Tokoro0917/RoboSweep_Mice2026/docs/rules/robosweep-rules.md

# ロボスイープ競技 ルールまとめ

調査日: 2026-11-12

> **注意: 公式の競技規程ページ（<https://ntf.or.jp/robosweep/rule/>）は、調査時点で非公開（404）でした。**
> このページは、確認できた資料と検索エンジンに残っていた抜粋から作ったものです。
> 規程が再公開されたら、必ず原文で確認して更新してください。

情報の確かさで 3 つに分けて書いています。

- **A. 一次資料で確認したこと**: 主催者が出した資料を直接読んで確認した
- **B. 規程の抜粋（未確認）**: 検索結果に残っていた規程の一部。原文は未確認
- **C. 解釈・推測**: A と B からの推測

---

## A. 一次資料で確認したこと

### 競技の概要
2026年度関西地区大会の告知（[マイクロマウス委員会 関西支部](https://mmk.rulez.jp/?p=3079)）より:

- 「複数台のロボットが協力してフィールド内のボールを減らし、得点を競う**対戦型**の競技」
- 2026年度から新しく始まった種目
- 参加費は**無料**（他の競技は 1 台 2000 円）
- エントリーは Google フォームから受け付けていた（関西大会の締切は 7/10）

### フィールド（関西大会で使われた迷路）
[公開されていた迷路の画像](https://ntf.or.jp/robosweep/wp-content/uploads/2026/07/FY26関西地区大会迷路.jpg)より:

- **16×16 区画の迷路**で、マイクロマウスの迷路と同じ形式
- 中央の太線で**左右に分かれていて、それぞれが各チームの陣地**
- ボール（黄色）は**各陣地に 2 個ずつ、計 4 個**置かれていた

### 大会の形式（関西大会）
[対戦表](https://ntf.or.jp/robosweep/wp-content/uploads/2026/07/FY26関西地区大会結果.png)より:

- 6 チームによるトーナメント。1 試合はおよそ 7〜15 分間隔で進行していた
- スコアは「0-5」「2-0」「0-3」「0-0」など
  - B にある「計測は 5 回で、1 回につき 1 点」という抜粋と矛盾しない
- 表彰は優勝・準優勝・特別賞

### 参加チームの構成例
優勝チームのエントリーシート（[2026kansai_entry_1.pdf](https://ntf.or.jp/robosweep/wp-content/uploads/2026/07/2026kansai_entry_1.pdf)）より:

- 同じ機体 2 台で 1 チーム。迷路を半分ずつ担当していた
- 2 台は Wi-Fi ルーターにつないだ同じ LAN 内で通信していた（ロボット同士の通信は使えるとみられる）
- ボールを吸引でつかみ、バネで打ち出す方式
- カメラで黄色い部分を見つけてボールを検出していた
- 主な部品: Raspberry Pi 5、ESP32-S3、ATmega328、IR 壁センサ、IMU、エンコーダ

### 公式の参考機体「ムブアイ」
三菱電機が、競技の参考になる機体の資料を公開しています（[ntf.or.jp/robosweep の uploads](https://ntf.or.jp/robosweep/wp-content/uploads/2026/06/)）。

- `機体HW.zip`: 回路図、CAD（STEP）、ハードウェア説明
- `ファームウェア.zip`: RX66N と FreeRTOS で動くファームウェア、説明資料
- `調整ソフト.zip`: Windows で動く調整用の GUI
- `ライセンス規約.pdf`

機体の主な仕様（ハードウェア説明より）:

- 重さ: 約 450 g
- 走行性能の目標: 最高速度 2 m/s
- バッテリー: Li-Po 2S 900mAh。連続 20 分動かすことを想定
- 処理系: Raspberry Pi 4B（通信・アルゴリズム）と RX66N（制御）
- ボールの扱い: 2 軸アームと遠心ファンで吸着する

> ⚠️ **ムブアイの資料はこのリポジトリに置かないでください。**
> ライセンス規約は「社外秘」扱いで、配布できるのは「本競技を目的とする開発グループ内」までです。
> **不特定の第三者への配布は禁止**されています。商用利用も禁止です。
> このリポジトリは Public なので、zip・PDF・CAD・ソースコード（改変したものも含む）をコミットすると規約違反になります。
> 各自が上の URL からダウンロードしてください。

---

## A2. チームで確認した規程の内容

チームの引き継ぎメモ（NTF 競技規程を読んだもの）より。

| 項目 | 内容 |
| --- | --- |
| フィールド | 18cm 区画が **16 × 16**。壁の高さ **5cm**、厚さ **1.2cm**（通路の内幅 16.8cm） |
| 陣地 | 両陣地は壁で分けられている。**本体の一部でも相手陣地に入ってはいけない** |
| ボール | ポリウレタン製、Φ70mm、19g。各陣地の指定位置に 2 個ずつ。**置く位置は事前に公表される** |
| 試合時間 | **5 分** |
| 得点 | 試合中の好きなタイミングで **5 回** ボールの数を数え、自陣のボールが少ないチームに 1 点 |

> ✅ **壁越しにボールを投げてよいことを、大会に確認しました**（2026-11-12、チームより）。
> アームを壁の上に出して、自動で相手陣地へ投げる方法で進めます（Issue #11）。
> 本体（車体）の一部を相手陣地に入れてはいけない、というルールは変わりません。

---

## B. 規程の抜粋（未確認）

検索エンジンに残っていた規程の一部です。**原文は確認できていません。**条番号は抜粋に書かれていたものです。

| 項目 | 内容 |
| --- | --- |
| 定義 | ロボットが自陣地の未知のフィールドにある複数のボールを自分で見つけ、相手陣地に送り込む。競技中に何回か各陣地のボール数を数え、その数をもとにポイントを競う |
| 1-1 | エージェント（ロボット）は自立型でなければならない。燃焼を使うエネルギー源は禁止 |
| 1-2 | 競技中に操作者がハードウェアやソフトウェアを変更してはいけない |
| — | ロボットの本体の一部でも相手陣地に入ってはいけない |
| — | 出場するロボットの**合計重量は 2.0 kg 以内**。台数の制限はない |
| — | ボールはポリウレタン製で、**直径 70 mm、重さ 19 g** |
| 3-1 | 競技開始時、両陣地の指定の位置にボールを 2 個ずつ置く |
| 4-2 | 競技開始前に決めたタイミングで**計 5 回**、各陣地のボール数を数える。そのとき**自陣のボールが少ないチームに 1 点** |
| 4-3 | フィールドの形は競技開始まで公開されない。事前に情報を手に入れてはいけない |

---

## C. 解釈・推測

- 迷路は事前に分からないので、**探索しながらボールを見つける**必要がある
- 自陣のボールを減らすことが得点につながる。車体は相手陣地に入れないので、アームで**壁越しに投げる**（大会に確認済み）
- 合計 2.0 kg 以内なら台数は自由なので、**台数と 1 台あたりの重さのバランス**が設計のポイントになる
- 5 回の計測で点が決まるので、序盤から早くボールを送ることが大事そう

## 不明なこと（規程の再公開待ち）

- 壁の色、床の色と材質
- 機体の大きさの制限
- 無線通信の規定（周波数、外部 PC を使ってよいか）
- 同点のときの決め方、反則とペナルティ
- スタート位置とスタートの手順

## 出典

- 関西地区大会の告知: <https://mmk.rulez.jp/?p=3079>
- 競技規程（調査時点で 404）: <https://ntf.or.jp/robosweep/rule/>
- 迷路・結果・エントリーシート・ムブアイ資料: <https://ntf.or.jp/robosweep/wp-content/uploads/>
