Tokoro0917/RoboSweep_Mice2026/hardware/electrical/remote-controller/production/bom.csv

Designator | Footprint | Quantity | Value | LCSC Part #
C1 | 0603 | 1 | 0.1u
C2 | 0603 | 1 | C_Small
D1, D2 | LED_D3.0mm | 2 | LED
DS1 | AQM0802A | 1 | AQM0802A
R1, R10, R11, R2, R3, R4, R5, R6, R7, R8 | 0603 | 10 | R
R9 | 0603 | 1 | 10k
SW1, SW2, SW3, SW4, SW5, SW6, SW7, SW8 | SW_PUSH_6mm | 8 | SW_Push
U1 | xiao_esp32c3 | 1 | XIAO ESP32C3
