Tokoro0917/RoboSweep_Mice2026/hardware/electrical/DOM-SWEEP/production/bom.csv

Designator | Footprint | Quantity | Value | LCSC Part #
C1, C10, C12, C5, C7, C9 | C_Radial_D5.0mm_H11.0mm_P2.00mm | 6 | 100u
C11, C13, C14, C16, C17, C19, C2, C20, C3, C4, C6 | 0603 | 11 | 0.1u
C15 | 0603 | 1 | 4.7u
C18 | 0805 | 1 | 22u
C8 | 0603 | 1 | 1u
D1 | 1N4007-3485 | 1 | 1N4007-3485
D6, D7, D8, D9, POWERLED1 | 0603 | 5 | LED
IC1 | QFP50P1200X1200X160-64N | 1 | STM32F446RET6
IC2 | NJM7805 | 1 | NJM7805
IC3, IC4 | SLA7073MPRT | 2 | SLA7073MPRT
IC5 | NJU7223F33 | 1 | NJU7223F33
J1 | MotorPinHeader | 1 | Motor_L
J2 | MotorPinHeader | 1 | Motor_R
J3 | PinHeader_2x03_P2.54mm_Vertical | 1 | Conn_02x03_Odd_Even
J4 | PinHeader_2x10_P2.54mm_Vertical | 1 | Conn_02x10_Odd_Even
JP1 | BatteryTerminal | 1 | ~
LED1, LED2, LED3, LED4 | OS5RKA5111P | 4 | OS5RKA5111P
Q1, Q3, Q7 | 2SC1815 | 3 | 2SC1815
Q2, Q6 | MTB060P06I3 | 2 | MTB060P06I3
Q4, Q5, Q8, Q9 | ST1KL3A | 4 | ST-1KL3A
R1, R12, R13, R16, R22, R3, R8 | 0603 | 7 | 10K
R10, R11, R14, R19, R2, R20, R23, R24, R25, R27, R7 | 0603 | 11 | 4.7K
R15 | Potentiometer_Bourns_3296W_Vertical | 1 | ~
R17, R9 | 0603 | 2 | 51
R4 | 0603 | 1 | 100K
R5 | 0603 | 1 | 22K
S3, S5, S6 | SMT(4.2X3.2) | 3 | SKRPACE010
S4 | SSSS213202 | 1 | SSSS213202
U2 | UGCM1205XP | 1 | UGCM1205XP
Y1 | CSTNE10M0G55A000R0 | 1 | CSTNE10M0G55A000R0
