Tokoro0917/RoboSweep_Mice2026/hardware/electrical/DOM-SWEEP/DOM-SWEEP.csv

Reference | Qty | Value | DNP | Exclude from BOM | Exclude from Board | Footprint | Datasheet
C1,C5,C7,C9,C10,C12 | 6 | 100u |  |  |  | Capacitor_THT:C_Radial_D5.0mm_H11.0mm_P2.00mm | ~
C2,C3,C4,C6,C11,C13,C14,C16,C17,C19,C20 | 11 | 0.1u |  |  |  | Capacitor_SMD:C_0603_1608Metric | ~
C8 | 1 | 1u |  |  |  | Capacitor_SMD:C_0603_1608Metric | ~
C15 | 1 | 4.7u |  |  |  | Capacitor_SMD:C_0603_1608Metric | ~
C18 | 1 | 22u |  |  |  | Capacitor_SMD:C_0805_2012Metric | ~
D1 | 1 | 1N4007-3485 |  |  |  | new_freshman_cm-footprint:1N4007-3485 | https://akizukidenshi.com/download/1n4007_panjit.pdf
D6,D7,D8,D9,PowerLED1 | 5 | LED |  |  |  | LED_SMD:LED_0603_1608Metric | ~
IC1 | 1 | STM32F446RET6 |  |  |  | STM32F446RET6:QFP50P1200X1200X160-64N | http://uk.rs-online.com/web/p/products/1106621P
IC2 | 1 | NJM7805 |  |  |  | new_freshman_cm-footprint:NJM7805 | https://datasheet.datasheetarchive.com/originals/distributors/Datasheets-DGA25/1772503.pdf
IC3,IC4 | 2 | SLA7073MPRT |  |  |  | new_freshman_cm-footprint:SLA7073MPRT | http://www.semicon.sanken-ele.co.jp/sk_content/sla7070mprt_ds_en.pdf
IC5 | 1 | NJU7223F33 |  |  |  | NJU7223F33 | https://www.nisshinbo-microdevices.co.jp/ja/pdf/datasheet/NJU7223_J.pdf
J1 | 1 | Motor_L |  |  |  | new_freshman_cm-footprint:MotorPinHeader | ~
J2 | 1 | Motor_R |  |  |  | new_freshman_cm-footprint:MotorPinHeader | ~
J3 | 1 | Conn_02x03_Odd_Even |  |  |  | Connector_PinHeader_2.54mm:PinHeader_2x03_P2.54mm_Vertical | ~
J4 | 1 | Conn_02x10_Odd_Even |  |  |  | Connector_PinHeader_2.54mm:PinHeader_2x10_P2.54mm_Vertical | ~
JP1 | 1 | ~ |  |  |  | new_freshman_cm-footprint:BatteryTerminal
LED1,LED2,LED3,LED4 | 4 | OS5RKA5111P |  |  |  | new_freshman_cm-footprint:OS5RKA5111P | http://akizukidenshi.com/download/ds/optosupply/OS5RKA5111P.pdf
Q1,Q3,Q7 | 3 | 2SC1815 |  |  |  | new_freshman_cm-footprint:2SC1815 | http://www.mouser.com/datasheet/2/68/2sc1815-1149989.pdf
Q2,Q6 | 2 | MTB060P06I3 |  |  |  | new_freshman_cm-footprint:MTB060P06I3 | https://datasheet.datasheetarchive.com/originals/distributors/Datasheets-SFU2/DSASFU100039949.pdf
Q4,Q5,Q8,Q9 | 4 | ST-1KL3A |  |  |  | new_freshman_cm-footprint:ST1KL3A | https://www.kodenshi.co.jp/files/product/ST-1KL3A.pdf
R1,R3,R8,R12,R13,R16,R22 | 7 | 10K |  |  |  | Resistor_SMD:R_0603_1608Metric | ~
R2,R7,R10,R11,R14,R19,R20,R23,R24,R25,R27 | 11 | 4.7K |  |  |  | Resistor_SMD:R_0603_1608Metric | ~
R4 | 1 | 100K |  |  |  | Resistor_SMD:R_0603_1608Metric | ~
R5 | 1 | 22K |  |  |  | Resistor_SMD:R_0603_1608Metric | ~
R9,R17 | 2 | 51 |  |  |  | Resistor_SMD:R_0603_1608Metric | ~
R15 | 1 | ~ |  |  |  | Potentiometer_THT:Potentiometer_Bourns_3296W_Vertical
S3,S5,S6 | 3 | SKRPACE010 |  |  |  | SKRPACE010:SMT(4.2X3.2) | http://www.alps.com/prod/info/E/HTML/Tact/SurfaceMount/SKRP/SKRPACE010.html
S4 | 1 | SSSS213202 |  |  |  | SSSS213202:SSSS213202 | http://uk.rs-online.com/web/p/products/1238917
U2 | 1 | UGCM1205XP |  |  |  | new_freshman_cm-footprint:UGCM1205XP | https://akizukidenshi.com/download/ds/universalelectronics/UGCM1205XP.pdf
Y1 | 1 | CSTNE10M0G55A000R0 |  |  |  | CSTNE10M0G55A000R0:CSTNE10M0G55A000R0 | https://www.murata.com/products/productdata/8801160101918/SPEC-CSTNE10M0G55A000R0.pdf
