Tokoro0917/RoboSweep_Mice2026/hardware/suction-effector/robosweep_bracket.stl

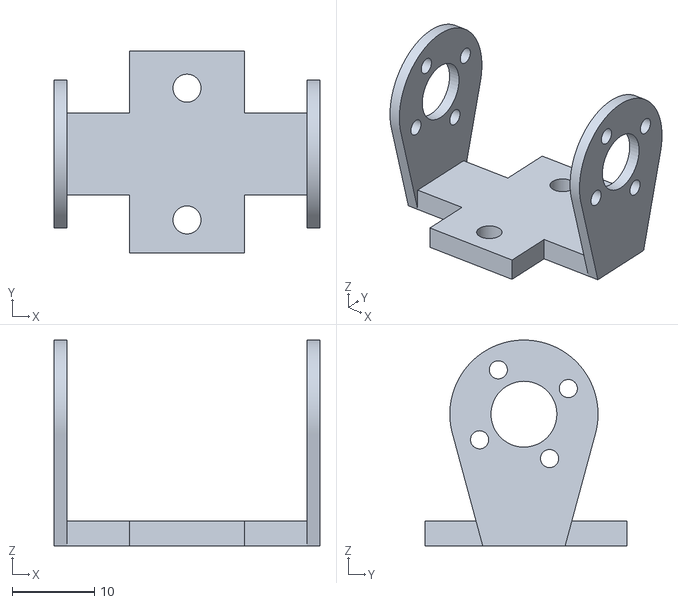
[picture p7: CAD file, 2026-11-13]
hardware/suction-effector/robosweep_bracket.stl
32.3 x 24.5 x 25.0
