Tokoro0917/RoboSweep_Mice2026/hardware/suction-effector/robosweep_bracket_pose.stl

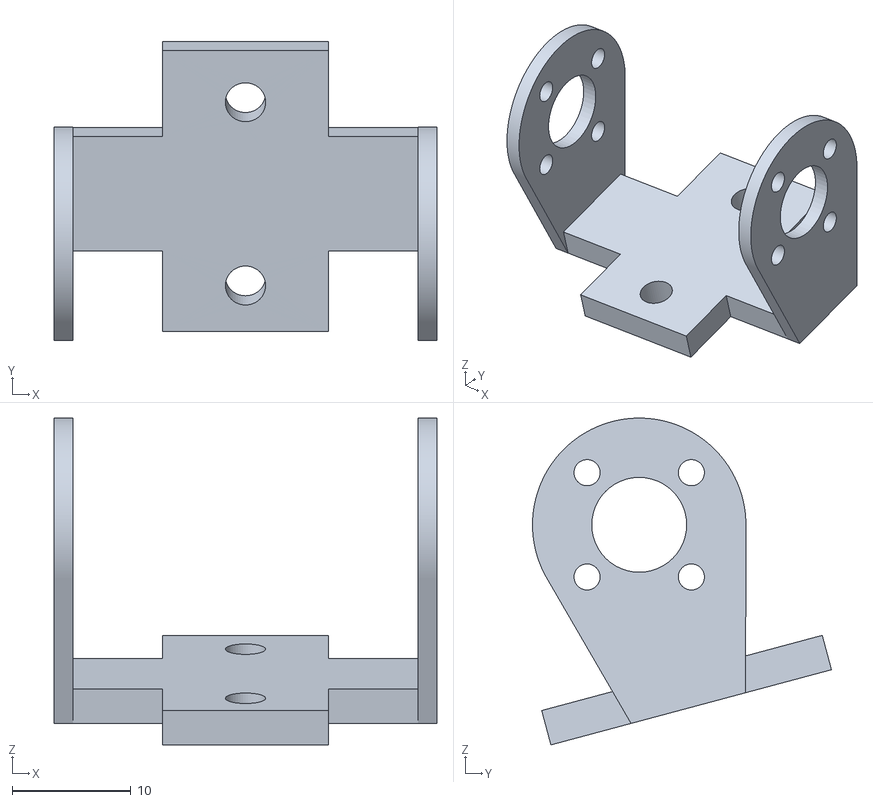
[picture p8: CAD file, 2026-11-13]
hardware/suction-effector/robosweep_bracket_pose.stl
32.3 x 25.2 x 27.6
