Tokoro0917/RoboSweep_Mice2026/hardware/suction-effector/robosweep_effector_upper_fit0.0.stl

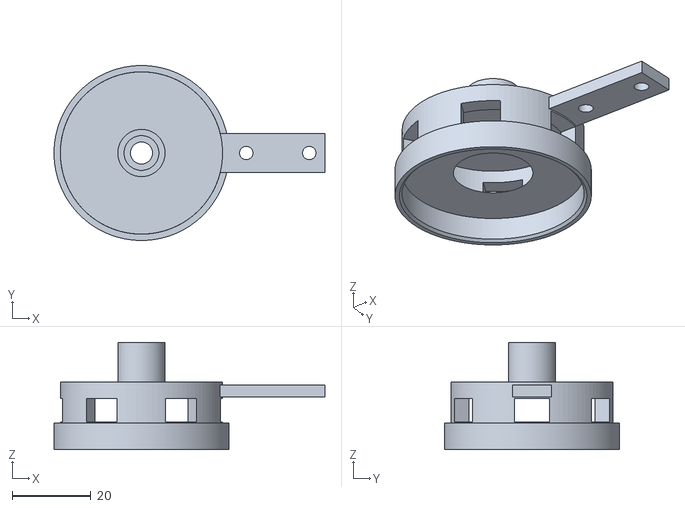
[picture p9: CAD file, 2026-11-12]
hardware/suction-effector/robosweep_effector_upper_fit0.0.stl
68.8 x 44.4 x 27.2
