Tokoro0917/RoboSweep_Mice2026/hardware/suction-effector/robosweep_impeller_d1.5.stl

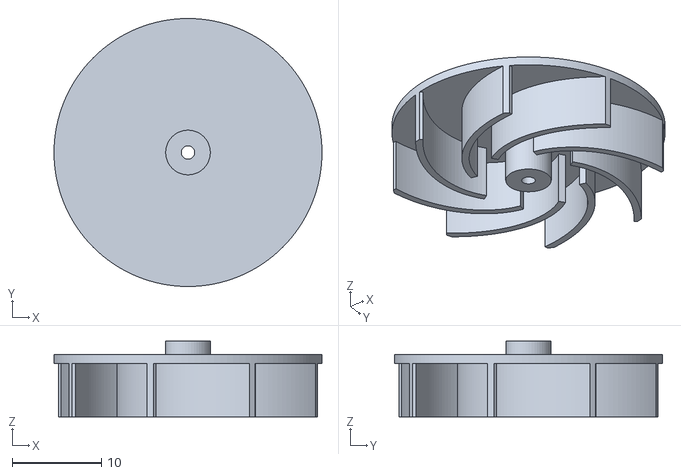
[picture p10: CAD file, 2026-11-12]
hardware/suction-effector/robosweep_impeller_d1.5.stl
30.0 x 30.0 x 8.50
