Tokoro0917/RoboSweep_Mice2026/hardware/suction-effector/robosweep_effector_lower.stl

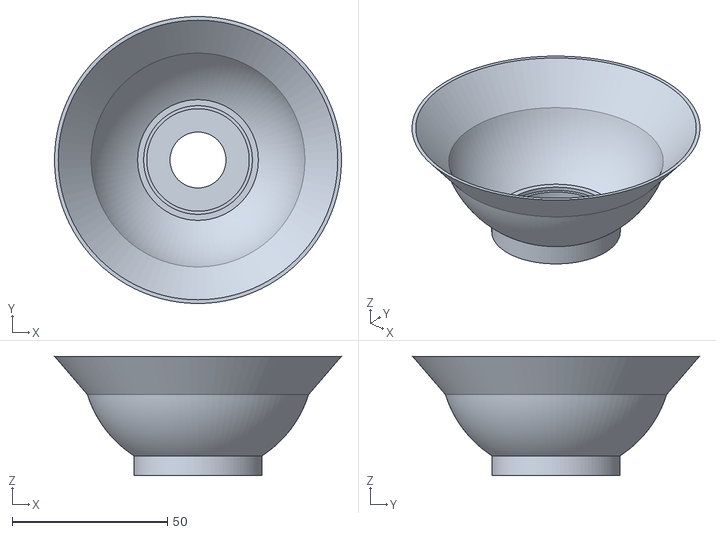
[picture p11: CAD file, 2026-11-12]
hardware/suction-effector/robosweep_effector_lower.stl
92.4 x 92.4 x 38.4
