Tokoro0917/RoboSweep_Mice2026/hardware/suction-effector/robosweep_effector_upper_fit-0.2.stl

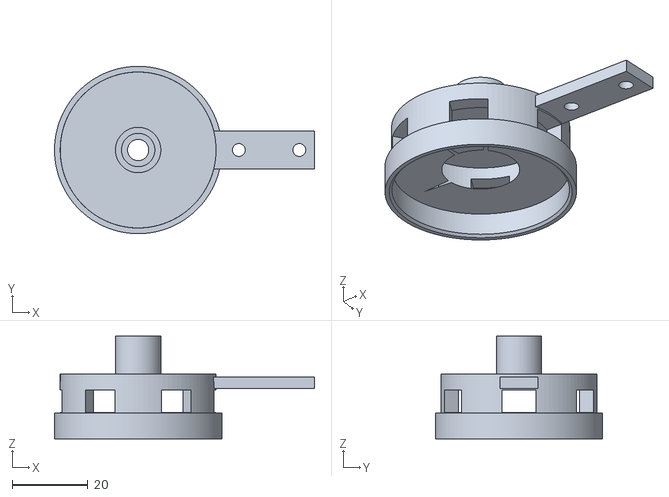
[picture p12: CAD file, 2026-11-12]
hardware/suction-effector/robosweep_effector_upper_fit-0.2.stl
68.7 x 44.2 x 27.2
