Tokoro0917/RoboSweep_Mice2026/hardware/suction-effector/robosweep_effector_upper_fit+0.1.stl

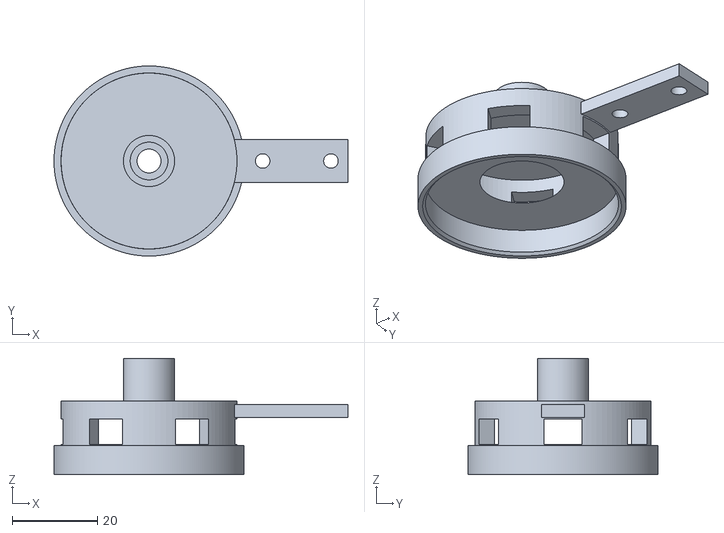
[picture p13: CAD file, 2026-11-12]
hardware/suction-effector/robosweep_effector_upper_fit+0.1.stl
68.9 x 44.5 x 27.2
