Tokoro0917/RoboSweep_Mice2026/hardware/suction-effector/fit_test_skirt.stl

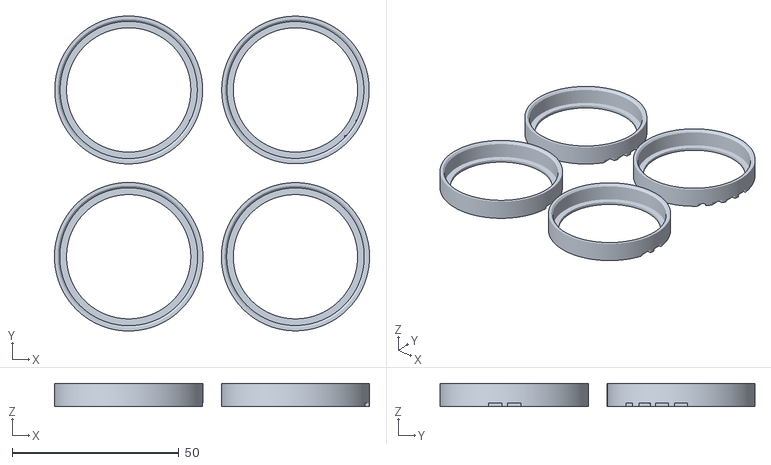
[picture p14: CAD file, 2026-11-12]
hardware/suction-effector/fit_test_skirt.stl
94.5 x 94.4 x 7.00
