Tokoro0917/RoboSweep_Mice2026/hardware/suction-effector/robosweep_effector_upper.stl

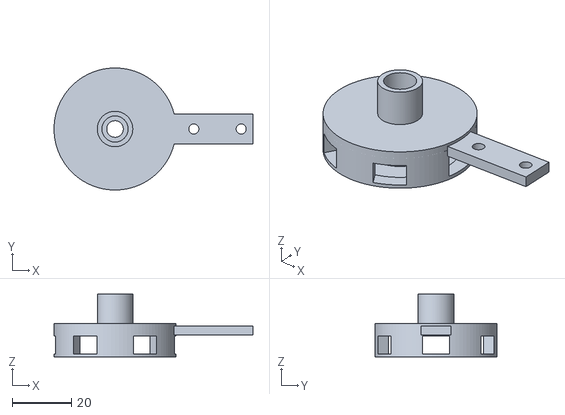
[picture p15: CAD file, 2026-11-12]
hardware/suction-effector/robosweep_effector_upper.stl
67.2 x 41.2 x 21.2
