Tokoro0917/RoboSweep_Mice2026/hardware/suction-effector/robosweep_impeller_original.stl

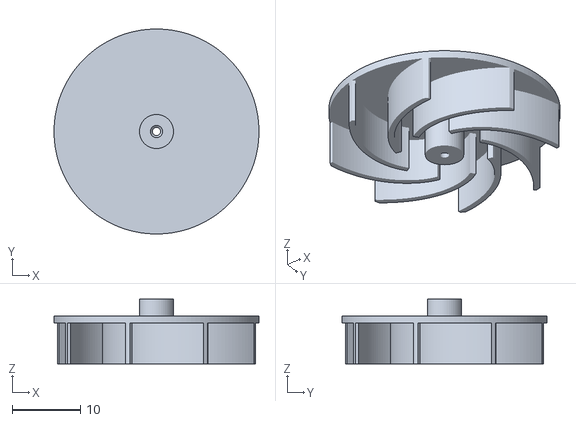
[picture p16: CAD file, 2026-11-12]
hardware/suction-effector/robosweep_impeller_original.stl
30.0 x 30.0 x 9.50
