Tokoro0917/RoboSweep_Mice2026/hardware/suction-effector/fit_test_p2s.stl

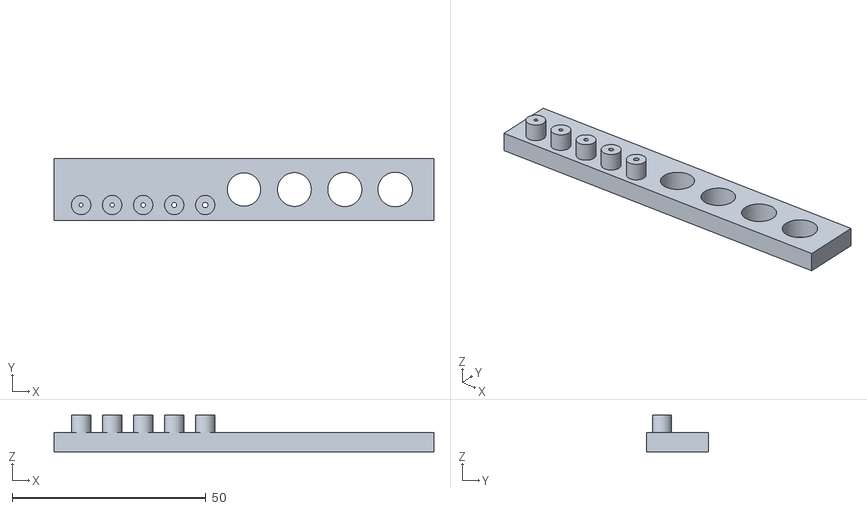
[picture p17: CAD file, 2026-11-12]
hardware/suction-effector/fit_test_p2s.stl
98.0 x 16.0 x 9.50
