Tokoro0917/RoboSweep_Mice2026/hardware/suction-effector/robosweep_effector_original.stl

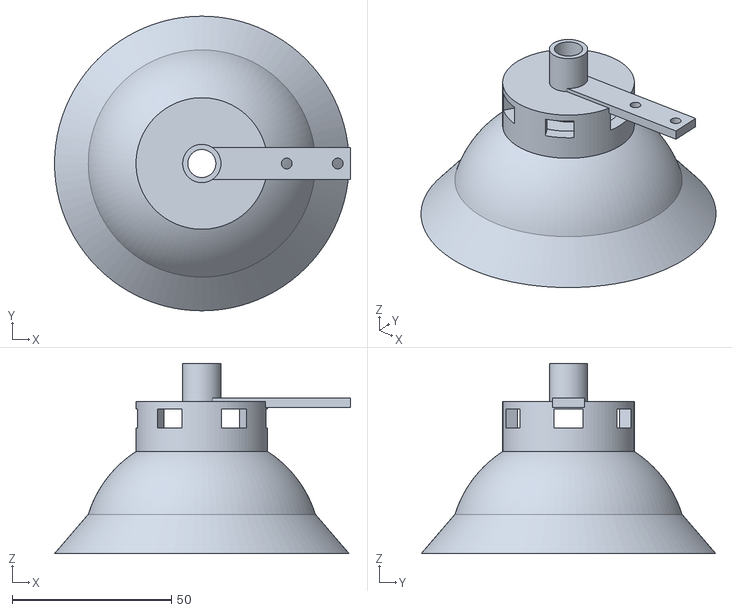
[picture p18: CAD file, 2026-11-12]
hardware/suction-effector/robosweep_effector_original.stl
92.8 x 92.4 x 59.6
