Tokoro0917/RoboSweep_Mice2026/(list of files, cad)

Other CAD files:
hardware/suction-effector/robosweep_impeller_d1.4.stl
hardware/suction-effector/robosweep_impeller_d1.3.stl
hardware/suction-effector/robosweep_impeller_d1.2.stl
hardware/cad/Mice_Sweep.f3z
hardware/suction-effector/robosweep_effector_upper_fit-0.1.stl
