Tokoro0917/RoboSweep_Mice2026/hardware/electrical/DOM-SWEEP/DOM-SWEEP.pdf

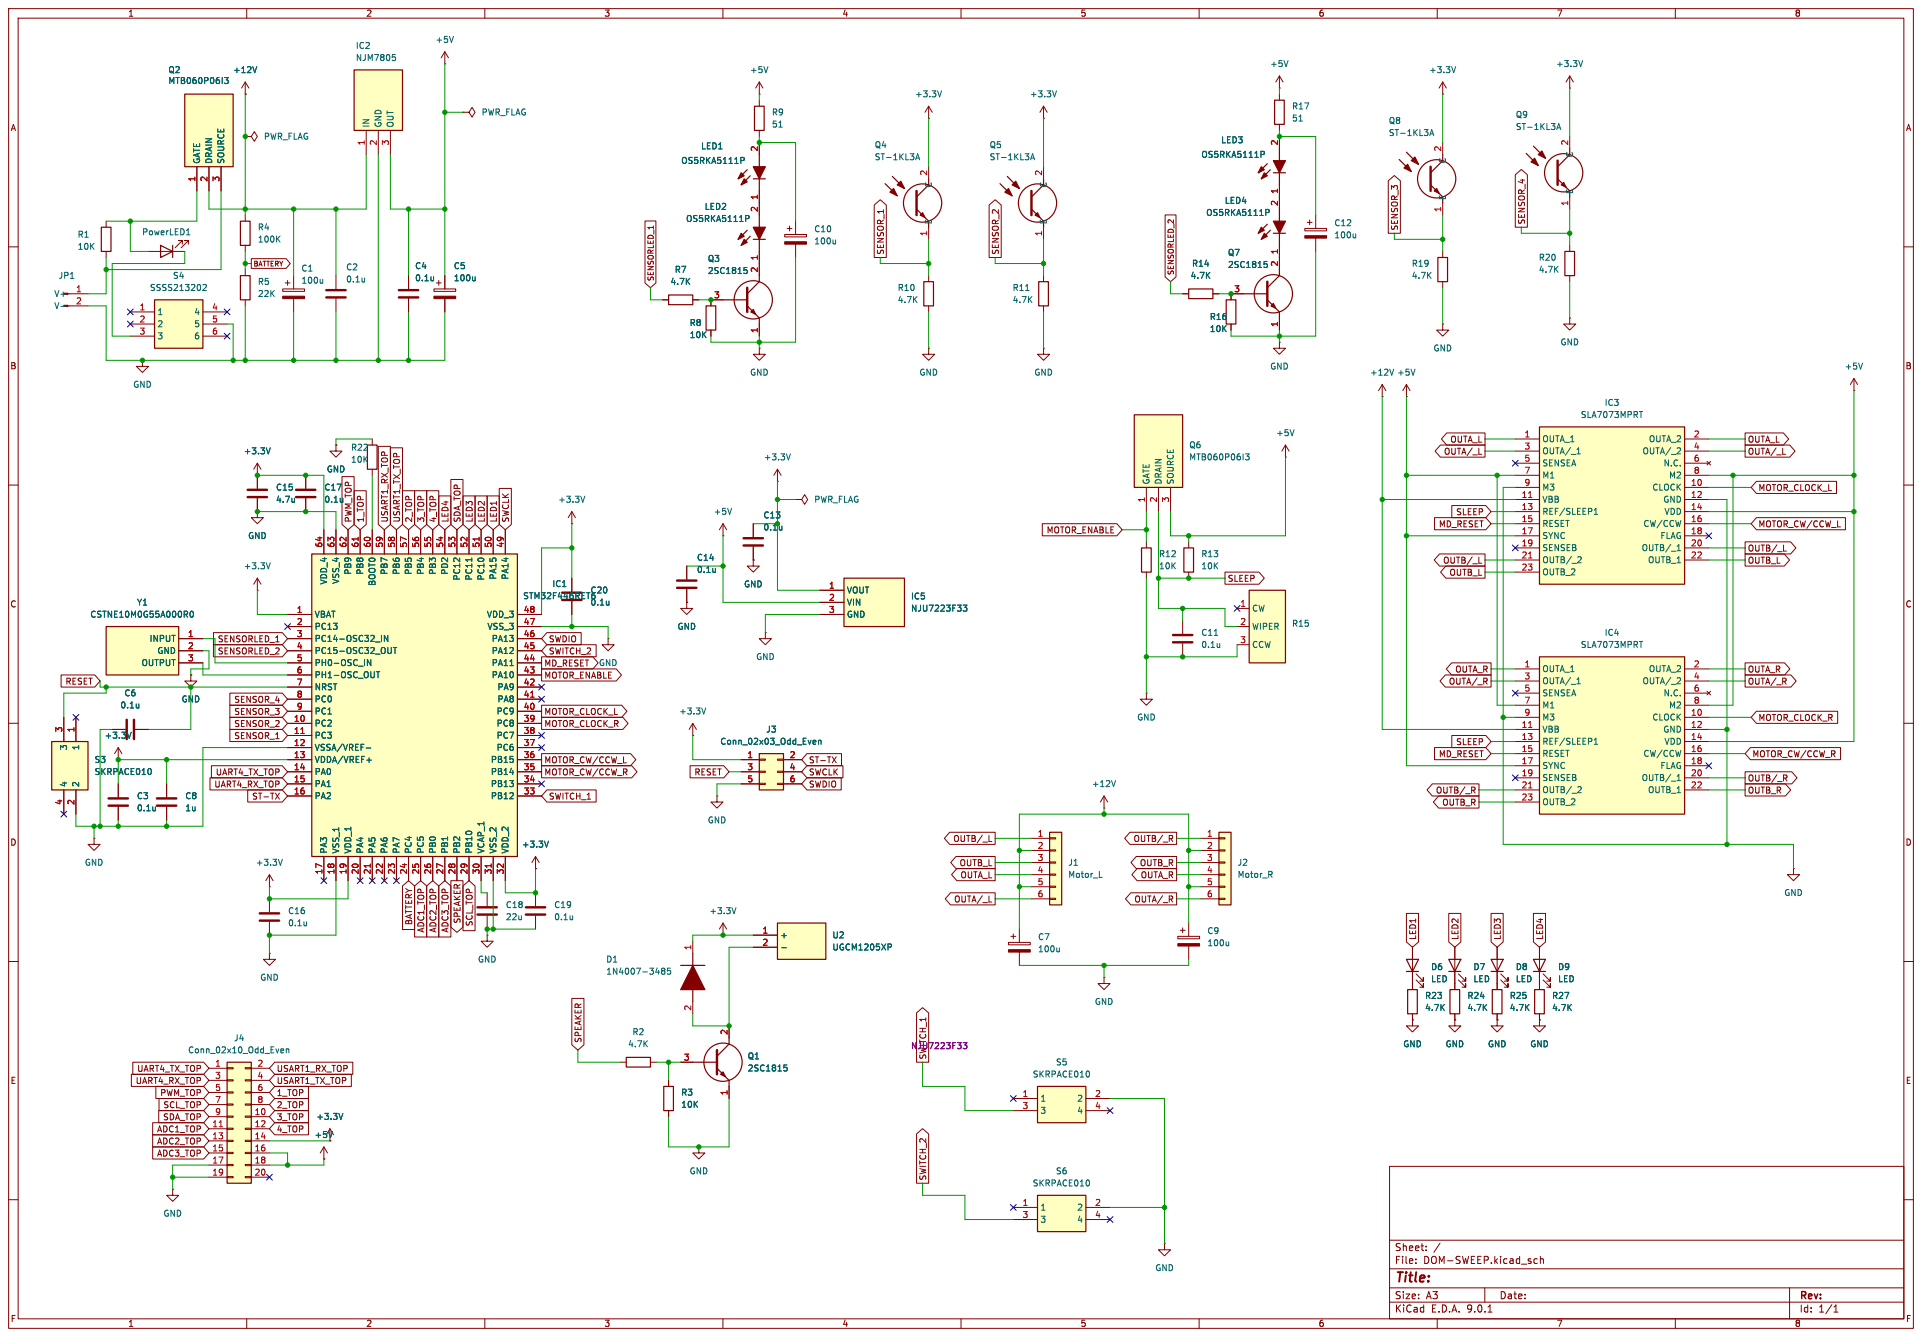
[picture p19: page 1]
