Tokoro0917/RoboSweep_Mice2026/hardware/electrical/remote-controller/rimocon.kicad_pcb

## KiCad design hardware/electrical/remote-controller/rimocon.kicad_pcb (2026-11-12)

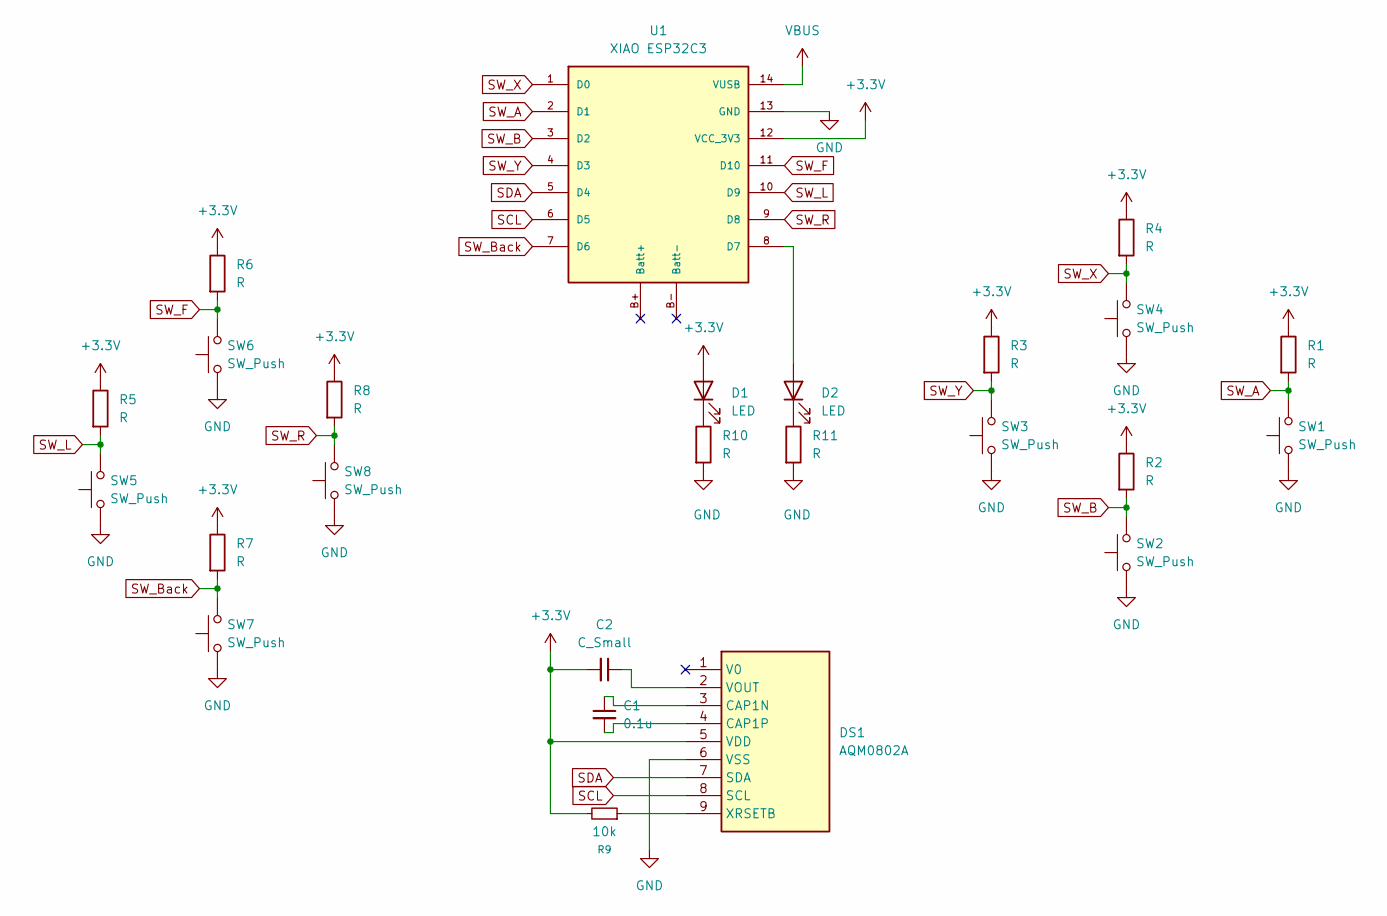
[picture p20: schematic rimocon.kicad_sch]

Parts:
C1: 0.1u; C_0603_1608Metric
C2: C_Small; C_0603_1608Metric
D1, D2: LED; LED_D3.0mm
DS1: AQM0802A; Manufacturer_Part_Number AQM0802A
R1, R2, R3, R4, R5, R6, R7, R8, R10, R11: R; R_0603_1608Metric
R9: 10k; R_0603_1608Metric
SW1, SW2, SW3, SW4, SW5, SW6, SW7, SW8: SW_Push; SW_PUSH_6mm
U1: XIAO ESP32C3; xiao_esp32c3

Connections:
+3.3V: C2.2, D1.2 (A), DS1.5 (VDD), R1.1, R2.1, R3.1, R4.1, R5.1, R6.1, R7.1, R8.1, R9.2, U1.12 (VCC_3V3)
GND: DS1.6 (VSS), R10.2, R11.2, SW1.1, SW2.1, SW3.1, SW4.1, SW5.1, SW6.1, SW7.1, SW8.1, U1.13 (GND)
unnamed: D1.1 (K), R10.1
unnamed: D2.2 (A), U1.8 (D7)
unnamed: D2.1 (K), R11.1
unnamed: C1.1, DS1.3 (CAP1N)
unnamed: C1.2, DS1.4 (CAP1P)
unnamed: C2.1, DS1.2 (VOUT)
unnamed: DS1.9 (XRSETB), R9.1
SCL: DS1.8 (SCL), U1.6 (D5)
SDA: DS1.7 (SDA), U1.5 (D4)
SW_A: R1.2, SW1.2, U1.2 (D1)
SW_B: R2.2, SW2.2, U1.3 (D2)
SW_Back: R7.2, SW7.2, U1.7 (D6)
SW_F: R6.2, SW6.2, U1.11 (D10)
SW_L: R5.2, SW5.2, U1.10 (D9)
SW_R: R8.2, SW8.2, U1.9 (D8)
SW_X: R4.2, SW4.2, U1.1 (D0)
SW_Y: R3.2, SW3.2, U1.4 (D3)
VBUS: U1.14 (VUSB)

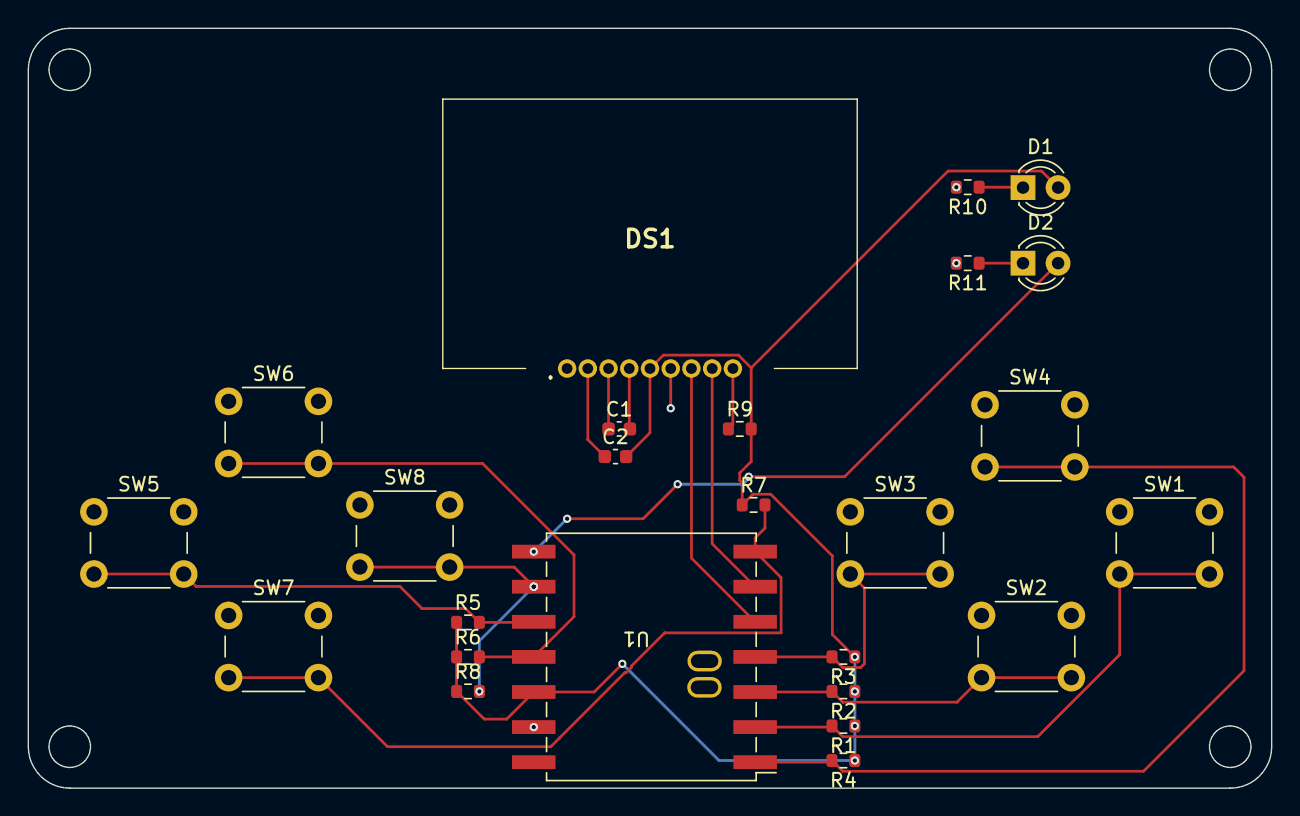
[picture p21: board rimocon.kicad_pcb from above]

Board: 2 copper layers, 90.0 x 55.0 mm, 25 parts (0 on the bottom side), 19 nets.
