Tokoro0917/RoboSweep_Mice2026/hardware/electrical/DOM-SWEEP/DOM-SWEEP.kicad_pcb

## KiCad design hardware/electrical/DOM-SWEEP/DOM-SWEEP.kicad_pcb (2026-11-12)

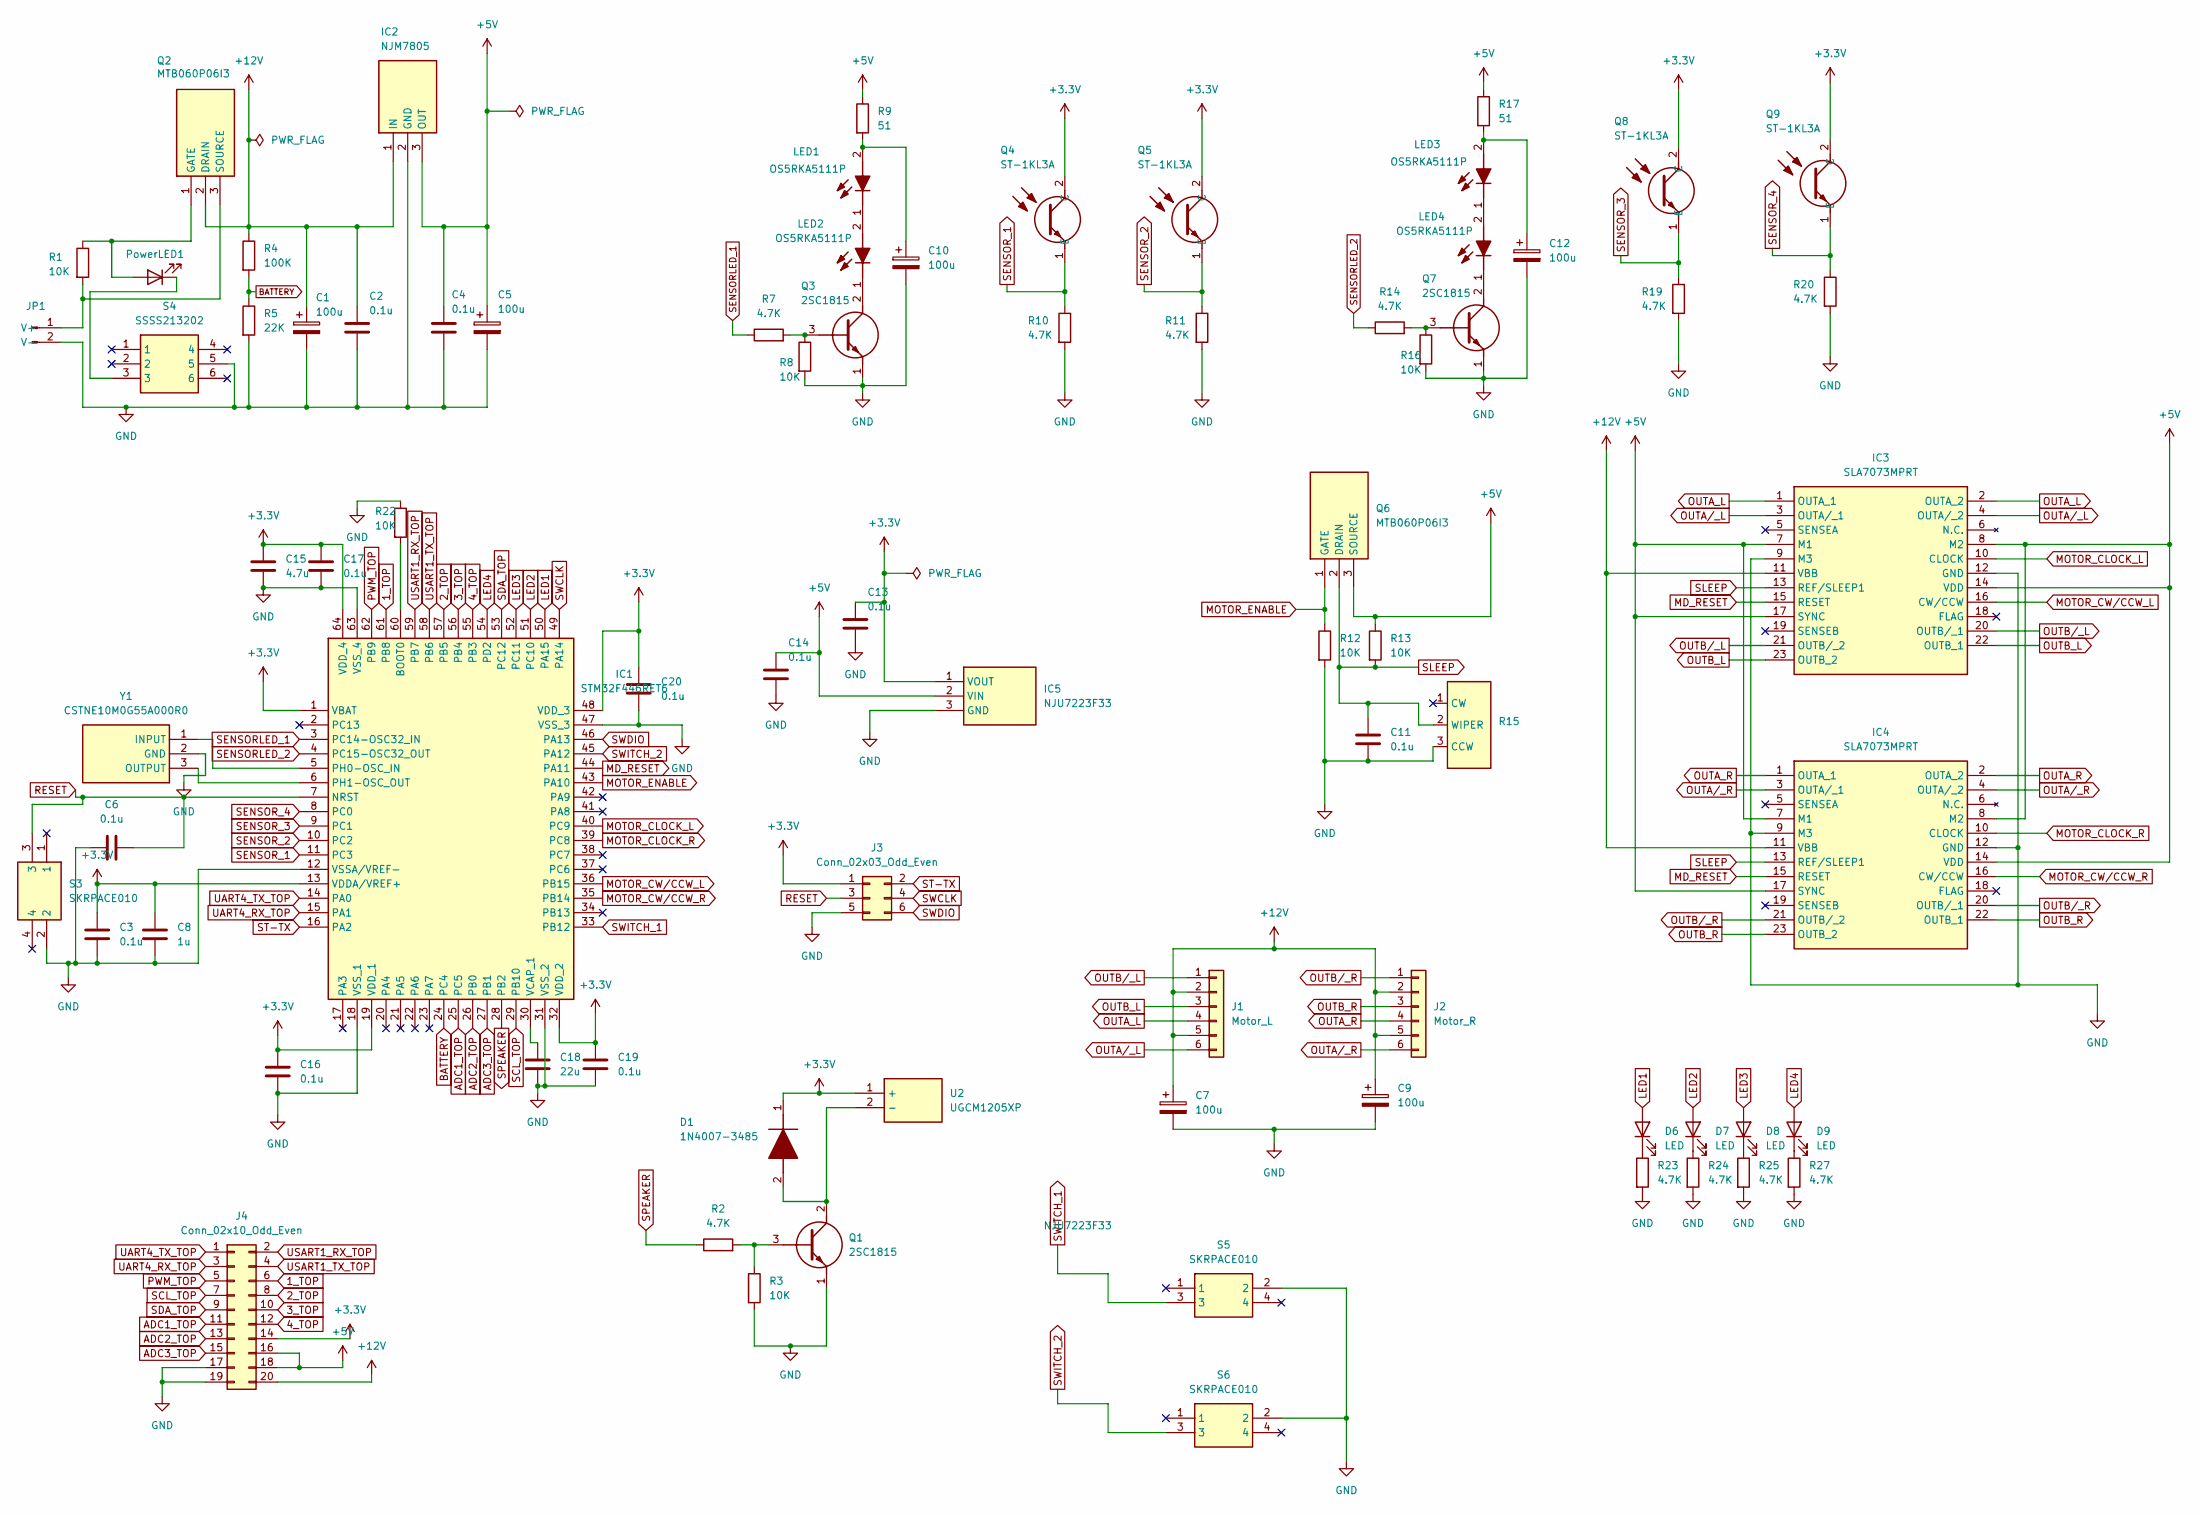
[picture p22: schematic DOM-SWEEP.kicad_sch]

Parts:
C1, C5, C7, C9, C10, C12: 100u; C_Radial_D5.0mm_H11.0mm_P2.00mm
C2, C3, C4, C6, C11, C13, C14, C16, C17, C19, C20: 0.1u; C_0603_1608Metric
C8: 1u; C_0603_1608Metric
C15: 4.7u; C_0603_1608Metric
C18: 22u; C_0805_2012Metric
D1: 1N4007-3485; Manufacturer_Part_Number 1N4007-3485
D6, D7, D8, D9: LED; LED_0603_1608Metric
IC1: STM32F446RET6; QFP50P1200X1200X160-64N; Manufacturer_Part_Number STM32F446RET6
IC2: NJM7805; Manufacturer_Part_Number NJM7805FA; Mouser Part Number 513-NJM7805FA
IC3, IC4: SLA7073MPRT; Manufacturer_Part_Number SLA7073MPRT
IC5: NJU7223F33; Manufacturer_Part_Number NJU7223F33; Mouser Part Number 513-NJU7223F33
J1: Motor_L; MotorPinHeader
J2: Motor_R; MotorPinHeader
J3: Conn_02x03_Odd_Even; PinHeader_2x03_P2.54mm_Vertical
J4: Conn_02x10_Odd_Even; PinHeader_2x10_P2.54mm_Vertical
JP1: BatteryTerminal
LED1, LED2, LED3, LED4: OS5RKA5111P; Manufacturer_Part_Number OS5RKA5111P
PowerLED1: LED; LED_0603_1608Metric
Q1, Q3, Q7: 2SC1815; Manufacturer_Part_Number 2SC1815; Mouser Part Number 610-2SC1815
Q2, Q6: MTB060P06I3; Manufacturer_Part_Number 2SJ681(Q); Mouser Part Number N/A
Q4, Q5, Q8, Q9: ST-1KL3A; ST1KL3A; Manufacturer_Part_Number ST-1KL3A
R1, R3, R8, R12, R13, R16, R22: 10K; R_0603_1608Metric
R2, R7, R10, R11, R14, R19, R20, R23, R24, R25, R27: 4.7K; R_0603_1608Metric
R4: 100K; R_0603_1608Metric
R5: 22K; R_0603_1608Metric
R9, R17: 51; R_0603_1608Metric
R15: Potentiometer_Bourns_3296W_Vertical
S3, S5, S6: SKRPACE010; SMT(4.2X3.2); Manufacturer_Part_Number SKRPACE010
S4: SSSS213202; Manufacturer_Part_Number SSSS213202
U2: UGCM1205XP; Manufacturer_Part_Number UGCM1205XP
Y1: CSTNE10M0G55A000R0; Manufacturer_Part_Number CSTNE10M0G55A000R0

Connections:
1_TOP: IC1.61 (PB8), J4.6
2_TOP: IC1.57 (PB5), J4.8
3_TOP: IC1.56 (PB4), J4.10
4_TOP: IC1.55 (PB3), J4.12
+3.3V: C3.1, C8.1, C13.1, C15.1, C16.1, C17.1, C19.1, C20.1, D1.1 (K), IC1.1 (VBAT), IC1.13 (VDDA/VREF+), IC1.19 (VDD_1), IC1.32 (VDD_2), IC1.48 (VDD_3), IC1.64 (VDD_4), IC5.1 (VOUT), J3.1, J4.14, Q4.2 (C), Q5.2 (C), Q8.2 (C), Q9.2 (C), U2.1 (+)
+5V: C4.1, C5.1, C14.1, IC2.3 (OUT), IC3.7 (M1), IC3.8 (M2), IC3.14 (VDD), IC3.17 (SYNC), IC4.7 (M1), IC4.8 (M2), IC4.14 (VDD), IC4.17 (SYNC), IC5.2 (VIN), J4.16, J4.18, Q6.3 (SOURCE), R9.1, R13.1, R17.1
+12V: C1.1, C2.1, C7.1, C9.1, IC2.1 (IN), IC3.11 (VBB), IC4.11 (VBB), J1.2, J1.5, J2.2, J2.5, J4.20, Q2.2 (DRAIN), R4.1
ADC1_TOP: IC1.25 (PC5), J4.11
ADC2_TOP: IC1.26 (PB0), J4.13
ADC3_TOP: IC1.27 (PB1), J4.15
BATTERY: IC1.24 (PC4), R4.2, R5.1
GND: C1.2, C2.2, C3.2, C4.2, C5.2, C6.1, C7.2, C8.2, C9.2, C10.2, C11.2, C12.2, C13.2, C14.2, C15.2, C16.2, C17.2, C18.2, C19.2, C20.2, IC1.12 (VSSA/VREF-), IC1.18 (VSS_1), IC1.31 (VSS_2), IC1.47 (VSS_3), IC1.63 (VSS_4), IC2.2 (GND), IC3.9 (M3), IC3.12 (GND), IC4.9 (M3), IC4.12 (GND), IC5.3 (GND), J3.5, J4.17, J4.19, JP1.2 (V-), Q1.1 (E), Q3.1 (E), Q7.1 (E), R3.2, R5.2, R8.2, R10.2, R11.2, R12.2, R15.3 (CCW), R16.2, R19.2, R20.2, R22.1, R23.2, R24.2, R25.2, R27.2, S3.2, S4.5, S5.2, S6.2, Y1.2 (GND)
LED1: D6.2 (A), IC1.50 (PA15)
LED2: D7.2 (A), IC1.51 (PC10)
LED3: D8.2 (A), IC1.52 (PC11)
LED4: D9.2 (A), IC1.54 (PD2)
MD_RESET: IC1.44 (PA11), IC3.15 (RESET), IC4.15 (RESET)
MOTOR_CLOCK_L: IC1.40 (PC9), IC3.10 (CLOCK)
MOTOR_CLOCK_R: IC1.39 (PC8), IC4.10 (CLOCK)
MOTOR_CW/CCW_L: IC1.36 (PB15), IC3.16 (CW/CCW)
MOTOR_CW/CCW_R: IC1.35 (PB14), IC4.16 (CW/CCW)
MOTOR_ENABLE: IC1.43 (PA10), Q6.1 (GATE), R12.1
unnamed: D1.2 (A), Q1.2 (C), U2.2 (-)
unnamed: D6.1 (K), R23.1
unnamed: D7.1 (K), R24.1
unnamed: D8.1 (K), R25.1
unnamed: D9.1 (K), R27.1
unnamed: IC1.60 (BOOT0), R22.2
unnamed: IC1.5 (PH0-OSC_IN), Y1.1 (INPUT)
unnamed: IC1.6 (PH1-OSC_OUT), Y1.3 (OUTPUT)
unnamed: C18.1, IC1.30 (VCAP_1)
unnamed: JP1.1 (V+), Q2.3 (SOURCE), R1.2
unnamed: C10.1, LED1.2 (A), R9.2
unnamed: LED1.1 (K), LED2.2 (A)
unnamed: LED2.1 (K), Q3.2 (C)
unnamed: C12.1, LED3.2 (A), R17.2
unnamed: LED3.1 (K), LED4.2 (A)
unnamed: LED4.1 (K), Q7.2 (C)
unnamed: PowerLED1.2 (A), Q2.1 (GATE), R1.1
unnamed: PowerLED1.1 (K), S4.3
unnamed: Q1.3 (B), R2.2, R3.1
unnamed: Q3.3 (B), R7.2, R8.1
unnamed: Q7.3 (B), R14.2, R16.1
OUTA_L: IC3.1 (OUTA_1), IC3.2 (OUTA_2), J1.4
OUTA_R: IC4.1 (OUTA_1), IC4.2 (OUTA_2), J2.4
OUTA/_L: IC3.3 (OUTA/_1), IC3.4 (OUTA/_2), J1.6
OUTA/_R: IC4.3 (OUTA/_1), IC4.4 (OUTA/_2), J2.6
OUTB_L: IC3.22 (OUTB_1), IC3.23 (OUTB_2), J1.3
OUTB_R: IC4.22 (OUTB_1), IC4.23 (OUTB_2), J2.3
OUTB/_L: IC3.20 (OUTB/_1), IC3.21 (OUTB/_2), J1.1
OUTB/_R: IC4.20 (OUTB/_1), IC4.21 (OUTB/_2), J2.1
PWM_TOP: IC1.62 (PB9), J4.5
RESET: C6.2, IC1.7 (NRST), J3.3, S3.3
SCL_TOP: IC1.29 (PB10), J4.7
SDA_TOP: IC1.53 (PC12), J4.9
SENSORLED_1: IC1.3 (PC14-OSC32_IN), R7.1
SENSORLED_2: IC1.4 (PC15-OSC32_OUT), R14.1
SENSOR_1: IC1.11 (PC3), Q4.1 (E), R10.1
SENSOR_2: IC1.10 (PC2), Q5.1 (E), R11.1
SENSOR_3: IC1.9 (PC1), Q8.1 (E), R19.1
SENSOR_4: IC1.8 (PC0), Q9.1 (E), R20.1
SLEEP: C11.1, IC3.13 (REF/SLEEP1), IC4.13 (REF/SLEEP1), Q6.2 (DRAIN), R13.2, R15.2 (WIPER)
SPEAKER: IC1.28 (PB2), R2.1
ST-TX: IC1.16 (PA2), J3.2
SWCLK: IC1.49 (PA14), J3.4
SWDIO: IC1.46 (PA13), J3.6
SWITCH_1: IC1.33 (PB12), S5.3
SWITCH_2: IC1.45 (PA12), S6.3
UART4_RX_TOP: IC1.15 (PA1), J4.3
UART4_TX_TOP: IC1.14 (PA0), J4.1
USART1_RX_TOP: IC1.59 (PB7), J4.2
USART1_TX_TOP: IC1.58 (PB6), J4.4

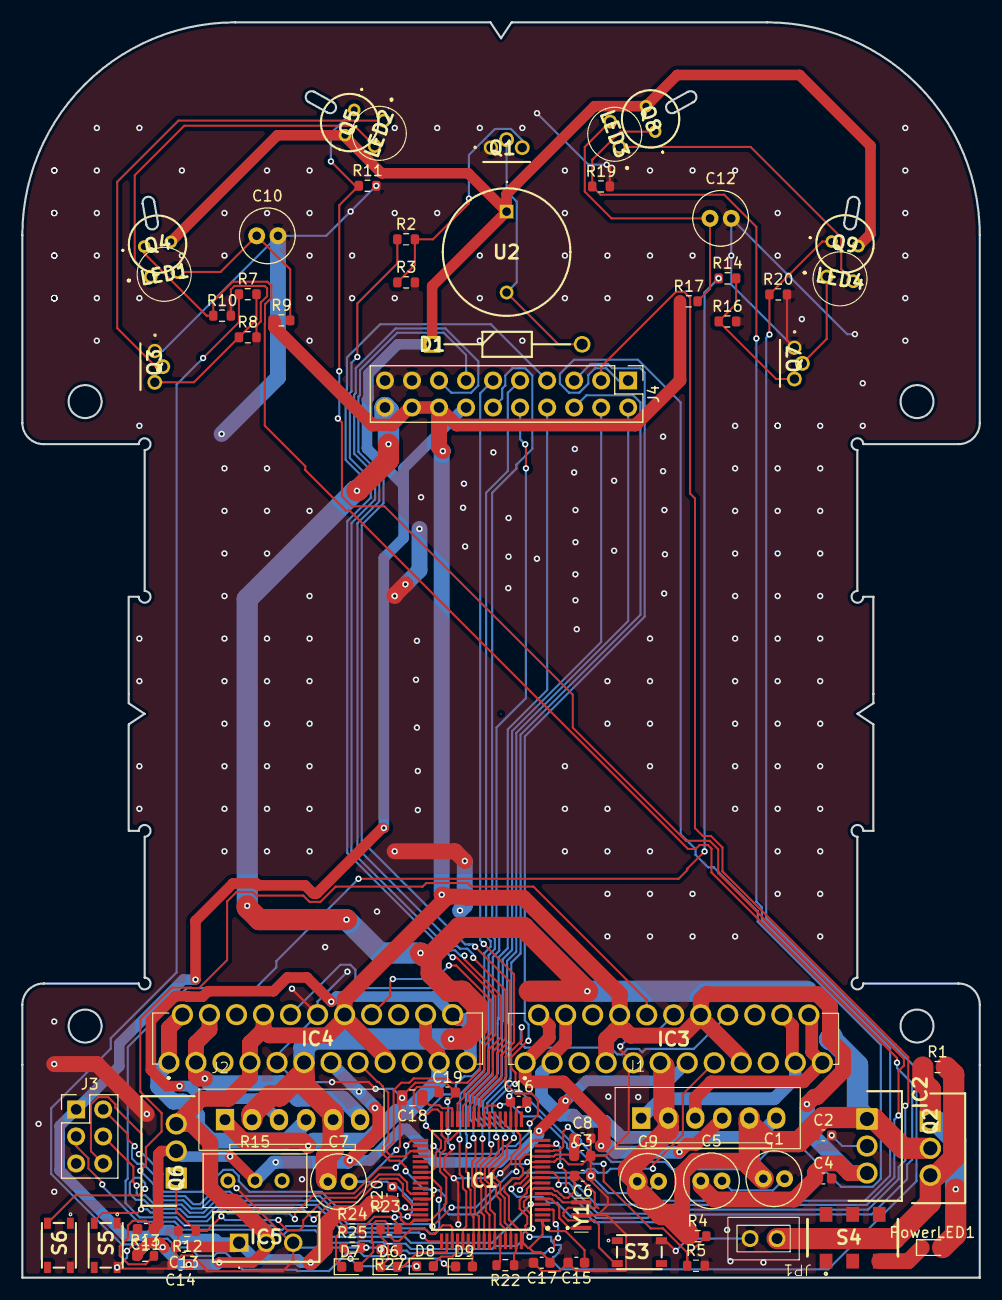
[picture p23: board DOM-SWEEP.kicad_pcb from above]

Board: 2 copper layers, 90.0 x 118.0 mm, 78 parts (0 on the bottom side), 72 nets.
