Tokoro0917/RoboSweep_Mice2026/software/firmware/MySWEEP1/MySWEEP1.ioc

Mcu.UserName=STM32F446RETx
PA0-WKUP.Signal=UART4_TX
PA1.Signal=UART4_RX
PA10.GPIO_Label=MOTOR_ENABLE
PA10.Signal=GPIO_Output
PA11.GPIO_Label=MD_RESET
PA11.Signal=GPIO_Output
PA15.GPIO_Label=LED_1
PA15.Signal=GPIO_Output
PA2.Signal=USART2_TX
PA3.Signal=USART2_RX
PB14.GPIO_Label=MOTOR_CW/CCW_R
PB14.Signal=GPIO_Output
PB15.GPIO_Label=MOTOR_CW/CCW_L
PB15.Signal=GPIO_Output
PB6.Signal=USART1_TX
PB7.Signal=USART1_RX
PB8.GPIO_Label=LED_T1
PB8.Signal=GPIO_Output
PB9.Signal=S_TIM4_CH4
PC0.GPIO_Label=SENSOR_4
PC0.Signal=ADCx_IN10
PC1.GPIO_Label=SENSOR_3
PC1.Signal=ADCx_IN11
PC10.GPIO_Label=LED_2
PC10.Signal=GPIO_Output
PC14-OSC32_IN.GPIO_Label=SENSORLED_1
PC14-OSC32_IN.Signal=GPIO_Output
PC15-OSC32_OUT.GPIO_Label=SENSORLED_2
PC15-OSC32_OUT.Signal=GPIO_Output
PC2.GPIO_Label=SENSOR_2
PC2.Signal=ADCx_IN12
PC3.GPIO_Label=SENSOR_1
PC3.Signal=ADCx_IN13
PC5.Signal=ADCx_IN15
PC8.GPIO_Label=MOTOR_CLOCK_R
PC8.Signal=S_TIM3_CH3
PC9.GPIO_Label=MOTOR_CLOCK_L
PC9.Signal=S_TIM8_CH4
PH0-OSC_IN.Signal=RCC_OSC_IN
PH1-OSC_OUT.Signal=RCC_OSC_OUT
