Tokoro0917/RoboSweep_Mice2026/software/firmware/MySWEEP1/Core/Src/main.c

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
/* Includes ------------------------------------------------------------------*/
#include "main.h"
#include "adc.h"
#include "dma.h"
#include "tim.h"
#include "usart.h"
#include "gpio.h"

/* USER CODE BEGIN Includes */
#include "app.h"
#include "drv_link.h"
/* USER CODE END Includes */


void SystemClock_Config(void);
/**
  * @brief  The application entry point.
  * @retval int
  */
int main(void)
{

  /* MCU Configuration--------------------------------------------------------*/

  /* Reset of all peripherals, Initializes the Flash interface and the Systick. */
  HAL_Init();

  /* Configure the system clock */
  SystemClock_Config();

  /* Initialize all configured peripherals */
  MX_GPIO_Init();
  MX_DMA_Init();
  MX_ADC1_Init();
  MX_TIM6_Init();
  MX_UART4_Init();
  MX_USART2_UART_Init();
  MX_TIM4_Init();
  MX_USART1_UART_Init();
  MX_TIM3_Init();
  MX_TIM8_Init();
  /* USER CODE BEGIN 2 */
  app_init();
  /* USER CODE END 2 */

  /* Infinite loop */
  /* USER CODE BEGIN WHILE */
  while (1)
  {
    app_loop();
    /* USER CODE END WHILE */

    /* USER CODE BEGIN 3 */
	}
  /* USER CODE END 3 */
}

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
/* USER CODE BEGIN 4 */
void HAL_UART_RxCpltCallback(UART_HandleTypeDef *huart) {
  if (huart->Instance == UART4) {
    link_on_rx();
  }
}

void HAL_UART_ErrorCallback(UART_HandleTypeDef *huart) {
  if (huart->Instance == UART4) {
    link_on_error();
  }
}

/* USER CODE END 4 */
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
