Tokoro0917/RoboSweep_Mice2026/software/firmware/MySWEEP1/Core/Inc/main.h

#define SENSORLED_1_Pin GPIO_PIN_14
#define SENSORLED_1_GPIO_Port GPIOC
#define SENSORLED_2_Pin GPIO_PIN_15
#define SENSORLED_2_GPIO_Port GPIOC
#define SENSOR_4_Pin GPIO_PIN_0
#define SENSOR_4_GPIO_Port GPIOC
#define SENSOR_3_Pin GPIO_PIN_1
#define SENSOR_3_GPIO_Port GPIOC
#define SENSOR_2_Pin GPIO_PIN_2
#define SENSOR_2_GPIO_Port GPIOC
#define SENSOR_1_Pin GPIO_PIN_3
#define SENSOR_1_GPIO_Port GPIOC
#define MOTOR_CW_CCW_R_Pin GPIO_PIN_14
#define MOTOR_CW_CCW_R_GPIO_Port GPIOB
#define MOTOR_CW_CCW_L_Pin GPIO_PIN_15
#define MOTOR_CW_CCW_L_GPIO_Port GPIOB
#define MOTOR_CLOCK_R_Pin GPIO_PIN_8
#define MOTOR_CLOCK_R_GPIO_Port GPIOC
#define MOTOR_CLOCK_L_Pin GPIO_PIN_9
#define MOTOR_CLOCK_L_GPIO_Port GPIOC
#define MOTOR_ENABLE_Pin GPIO_PIN_10
#define MOTOR_ENABLE_GPIO_Port GPIOA
#define MD_RESET_Pin GPIO_PIN_11
#define MD_RESET_GPIO_Port GPIOA
#define LED_1_Pin GPIO_PIN_15
#define LED_1_GPIO_Port GPIOA
#define LED_2_Pin GPIO_PIN_10
#define LED_2_GPIO_Port GPIOC
#define LED_T1_Pin GPIO_PIN_8
#define LED_T1_GPIO_Port GPIOB
