Tokoro0917/RoboSweep_Mice2026/(commit log)

2026-11-12 共同作業のためのリポジトリ構成とルールを追加
    - README: 概要とディレクトリ構成
    - CONTRIBUTING: 作業の流れ、ブランチ命名ルール、コミット/PRの書き方
    - PR テンプレートと Issue テンプレート（タスク・不具合・相談）
    - docs / hardware / software のディレクトリ
    - .gitignore / .gitattributes
    Claude-Session: https://claude.ai/code/session_01H2ZvpprshQ9HuEhVGoJh3T
2026-11-12 ロボスイープ競技のルール調査結果を追加
    公式規程ページが非公開のため、一次資料・規程抜粋・推測を分けて記載。
    参考機体（ムブアイ）の資料はライセンス上 Public リポジトリに置けない旨を明記。
    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
2026-11-12 CONTRIBUTING にムブアイ資料をコミットしない旨を追記
    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
2026-11-12 README: Mice はチーム名であることを明記し、ルールまとめへのリンクを追加
    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
2026-11-12 機体の Fusion 360 アセンブリ (Mice_Sweep.f3z) を追加
    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
    [Mice_Sweep.f3z]
2026-11-12 README: スケジュールに12月末の練習会と全日本大会を追記
    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
2026-11-12 本体基板 DOM-SWEEP の KiCad プロジェクトを追加
    - 回路図・基板・部品表・発注用データを hardware/electrical/DOM-SWEEP/ に配置
    - ライブラリの参照先を個人の PC のパスから相対パスに変更
    - KiCad の自動バックアップと個人設定を .gitignore に追加
    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
    [DOM-SWEEP.csv, DOM-SWEEP.kicad_pcb, DOM-SWEEP.kicad_sch, bom.csv, designators.csv, positions.csv]
2026-11-12 リモコン操作のテスト用ファームウェアを追加
    - STM32CubeIDE プロジェクト MySWEEP1（走行・アーム・吸引ファンの動作確認用）
    - ESP32 リモコンのプログラム（ESP-NOW 送信側）
    - ビルド成果物と個人のデバッグ設定は除外し、.gitignore に追加
    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
2026-11-12 リモコン基板 rimocon の KiCad プロジェクトを追加
    - 回路図・基板・発注用データと XIAO ESP32C3 ライブラリ（GPL-3.0）を配置
    - 配布禁止の SamacSys ライブラリ、KiCad の履歴・バックアップ・個人設定は除外
    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
    [bom.csv, designators.csv, positions.csv, rimocon.kicad_pcb, rimocon.kicad_sch]
2026-11-12 リモコン機のプログラムを作り直し、機体の仕様書を追加
    - 走行・モーター・壁センサ・アーム・サーボ・リモコン受信を別々のファイルに分けた
    - 調整する値を config.h にまとめた
    - 制御の周期を 1ms に直した（TIM6 が初期値のままで約 0.73ms だった）
    - 速度の計算をタイマーの実際のクロック 11.25MHz に合わせた
    - 進んだ距離をパルス数から数えるようにした
    - リモコンの信号が途切れたら止まるようにした
    - .ioc の TIM8 プリスケーラを tim.c に合わせた
    - CubeIDE なしでビルドできる Makefile と、走行の計算の PC 用テストを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
2026-11-12 README に、クローンの方法と GitHub に上げる手順を追加
    GitHub Desktop とコマンドの両方の手順と、困ったときの対処を書いた。
    CONTRIBUTING の「基本の流れ」は README を参照する形にした。
    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
2026-11-12 機体に載せる受信用 ESP32 のプログラムを追加
    元のプログラムが見つからなかったため作り直した。
    - ESP-NOW で受けたボタンを 0xAA, ボタン, 0x55 の形で STM32 に送る
    - 50ms ごとに送り続け、リモコンから 200ms 届かなければボタンなしを送る
    - 起動時に MAC アドレスを USB シリアルに表示
    - 仕様書と README にボタンの対応と配線を追記
    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
2026-11-12 機体のプログラムを一から書き直した
    前のプログラムからはピン・通信形式・アームの角度などハードの事実だけを使い、
    構成と中身を新しく作った。
    - drv_*: モーター・壁センサ・サーボ・ファン・受信・LED・時間
    - モーターは次の周期を予約で書き、回転方向はパルスを休んでから切り替える
    - 壁センサは LED を交互に点けて 1ms ごとに測り、LED の点灯時間を短くした
    - ctl_motion: 台形加速と位置 (x, y, 角度)、ctl_wall: 横の壁の PD 補正
    - app_arm: アームの動作を待たずに進める
    - app: リモコン操作・LED 表示・USART2 への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
2026-11-12 ボール吸着ユニットの資料を追加し、ルールまとめを更新
    - hardware/suction-effector/README.md: 引き継ぎメモの方針・仕様・印刷条件・次にやること
    - ルールまとめ: フィールド寸法・試合時間・ボール位置の公表などを追加し、
    壁越しの送り込みは大会への確認が必要なことを明記
    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
2026-11-12 吸着ユニット・インペラ・はめあい試験片の STL を追加
    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
    [fit_test_p2s.stl, robosweep_effector.stl, robosweep_impeller.stl]
2026-11-12 ルールまとめ: 壁越しに投げてよいことを大会に確認済みと記載
    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
2026-11-12 吸着ユニットを印刷できる上下 2 部品に分けた
    インペラ室が閉じていてインペラを入れられないため、吸込口の板の上面で分割。
    - robosweep_effector_lower.stl / _upper.stl（印刷の向き）
    - 元の形は robosweep_effector_assembled.stl として確認用に残した
    - 分けるスクリプト tools/split_effector.py
    - README に組み立て方と印刷の注意（アームの下だけサポート）を追記
    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
    [robosweep_effector_assembled.stl, robosweep_effector_lower.stl, robosweep_effector_upper.stl]
2026-11-12 インペラ室の天井を直し、軸穴を広げたインペラと説明画像を追加
    - 取り付けアームの下面がインペラ室に 0.6mm はみ出し、室の高さが 7.4mm（インペラ 7.0mm）
    しかなかったので、はみ出しを削って 8.0mm にそろえた（組み立てた形と上下の部品）
    - 軸穴 Φ1.2 は印刷で細くなり軸が入らないため、Φ1.3 / Φ1.4 のインペラを追加
    - 断面図・部品図・インペラの画像と、それを作るスクリプトを追加
    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
    [robosweep_effector_assembled.stl, robosweep_effector_lower.stl, robosweep_effector_upper.stl, robosweep_impeller_d1.2.stl, robosweep_impeller_d1.3.stl, robosweep_impeller_d1.4.stl]
2026-11-12 軸穴 Φ1.5 のインペラを追加
    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
    [robosweep_effector_assembled.stl, robosweep_impeller_d1.5.stl]
2026-11-12 インペラのハブを 1mm 短くし、スクリプトを元の形から作り直す形にした
    - インペラの円板の上に出ているハブを 1mm 短くした（高さ 9.5mm → 8.5mm）
    - 受け取った元の形を *_original.stl として残し、fix_parts.py はそこから作るようにした
    （前のコミットでは同じ直しを 2 回かけて組み立てた形の STL が閉じていなかった）
    - 画像を作り直した
    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
    [robosweep_effector_assembled.stl, robosweep_effector_original.stl, robosweep_impeller_d1.2.stl, robosweep_impeller_d1.3.stl, robosweep_impeller_d1.4.stl, robosweep_impeller_d1.5.stl, robosweep_impeller_original.stl]
2026-11-12 上の部品に、下の部品へはめ込むスカートを付けた
    - 下の部品の筒（Φ41.67）にかぶさるスカート（高さ 4.5mm、厚さ 1.6mm、入口の面取り 0.6mm）
    - すき間（直径）0.1 / 0.2 / 0.3mm の 3 通りと、合うものを選ぶ試験リングを追加
    - 上下方向はインペラ室の壁の下端が板に当たって止まり、室の高さ 8mm は変わらない
    - 画像と README（組み立て・印刷の注意）を更新
    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
    [fit_test_skirt.stl, robosweep_effector_upper_fit0.1.stl, robosweep_effector_upper_fit0.2.stl, robosweep_effector_upper_fit0.3.stl]
2026-11-12 吸着ユニットをサーボ2に付ける取り付け金具を追加
    - サーボ2の両側のホーンを挟み M2 で留め、吸着ユニットのアームを M3 × 2 で留めるコの字形
    - ボールを吸うとき吸着ユニットの後ろ側が 15° 下がる向き（案B）
    - 機体全体の STEP（全体 v11）で、吸う姿勢（腕 約 25°、ボールは機体の前の端から約 19mm 前）で
    金具・吸着ユニット・モーターが機体にぶつからないことを確認
    - 姿勢の図・金具の図と README を追加
    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
    [robosweep_bracket.stl, robosweep_bracket_pose.stl]
2026-11-12 吸着ユニットの README を直した（はめ込みの説明を入れたときに壊れていた）と金具の説明を追加
    190f7de で README を書き換える処理が空の文字列を置き換えてしまい、
    同じ文章が文字ごとに差し込まれて約 27,000 行になっていた。
    c2ad007 の README に戻して、はめ込み・取り付け金具の説明を入れ直した。
    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
2026-11-12 試し刷りの結果を反映: はめ込みはすき間 0.1mm、インペラの軸穴は Φ1.5 に決定
    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
2026-11-12 インペラ室を高さ 10mm にし、モーターの止めを付けた。軸の中心のずれを直した
    - インペラ室の天井を 2mm 上げて高さ 10mm に（インペラとの上下のすき間 1.5mm ずつ）。内径は Φ33 のまま
    - 天井の穴を Φ5.6 にして、モーターが天井の上面で止まるようにした
    - インペラは羽根 6mm のまま（全体の高さ 8.5mm）
    - これまで外形の中心（軸から 0.21mm ずれている）を軸として計算していたのを、本当の軸 (0, 0) に直した
    - 下の部品の筒の外径は Φ41.24（Φ41.67 は誤り）。スカートを同心にし、すき間 0.2〜0.5mm の 4 通りに
    - アーム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
    [fit_test_skirt.stl, robosweep_bracket.stl, robosweep_bracket_pose.stl, robosweep_effector_assembled.stl, robosweep_effector_lower.stl, robosweep_effector_upper.stl, robosweep_effector_upper_fit0.1.stl, robosweep_effector_upper_fit0.2.stl]
2026-11-12 はめ込みのすき間を +0.1 / 0 / -0.1 / -0.2mm に変更（+0.2〜+0.5mm はどれもゆるかった）
    - 試験リングと上の部品 4 通りを作り直した
    - 保存した STL が閉じた形になるよう、頂点をまとめてつぶれた三角形を消す処理を追加
    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
    [fit_test_skirt.stl, robosweep_effector_upper_fit+0.1.stl, robosweep_effector_upper_fit-0.1.stl, robosweep_effector_upper_fit-0.2.stl, robosweep_effector_upper_fit0.0.stl, robosweep_effector_upper_fit0.2.stl, robosweep_effector_upper_fit0.3.stl, robosweep_effector_upper_fit0.4.stl]
2026-11-12 はめ込みをすき間 -0.1mm（内径 Φ41.14）に決め、スカートを 6mm に深くした
    - 試験リングでは切り欠き 3 個（-0.1mm）がちょうどよかった
    - スカートの高さ 4.5mm → 6.0mm（下の部品の筒のまっすぐな部分 6.4mm のほとんど）
    - スカート付きで、ボールを吸う姿勢で機体にぶつからないことを確認
    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
    [fit_test_skirt.stl, robosweep_effector_upper_fit+0.1.stl, robosweep_effector_upper_fit-0.1.stl, robosweep_effector_upper_fit-0.2.stl, robosweep_effector_upper_fit0.0.stl]
2026-11-12 取り付け金具: 左右の板を 2.5→1.6mm に薄くし、中央の穴を Φ6.5→Φ8.6 に広げた
    ホーン中央の出っ張り（Φ8）に穴が当たっていたため。
    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
    [robosweep_bracket.stl, robosweep_bracket_pose.stl]
2026-11-13 取り付け金具: 中央の穴を Φ8.6 → Φ8 に変更
    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
    [robosweep_bracket.stl, robosweep_bracket_pose.stl]
