Tokoro0917/RoboSweep_Mice2026/(notices)

Notices in the files:
software/firmware/MySWEEP1/Core/Inc/main.h:
Copyright (c) 2026 STMicroelectronics.
All rights reserved.
This software is licensed under terms that can be found in the LICENSE file
